kill4n/FEALAC/Hardware/renders/rend.JPG

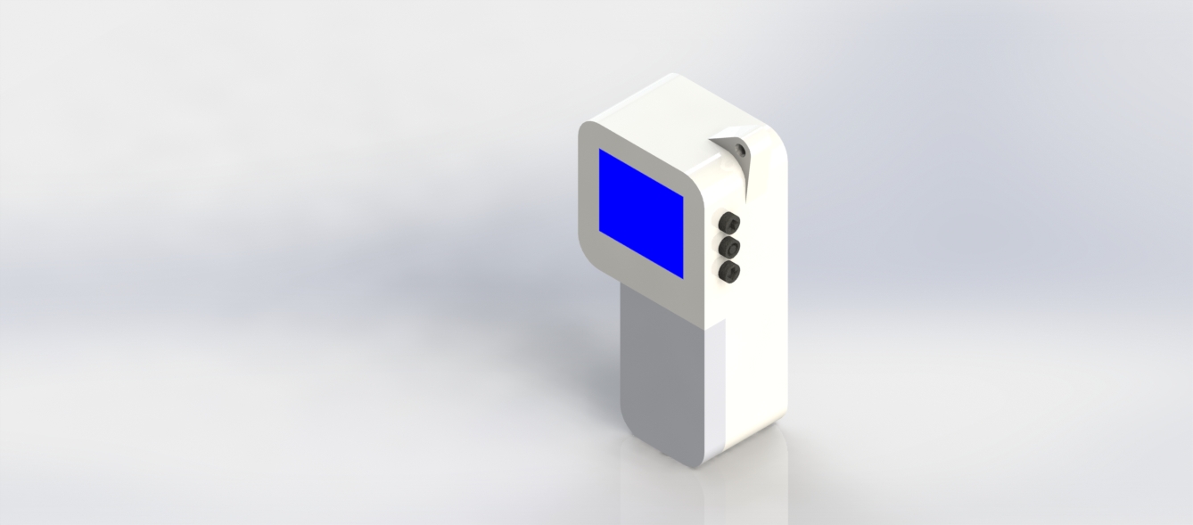
Hardware/renders/rend.JPG
