kill4n/FEALAC/Hardware/renders/rendexp.JPG

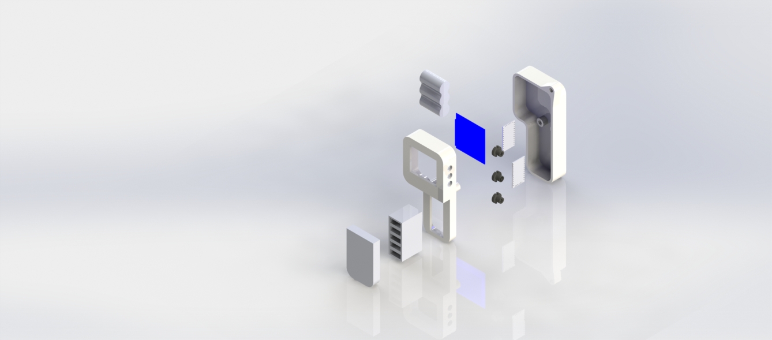
Hardware/renders/rendexp.JPG
