kill4n/FEALAC/Hardware/Ensamblaje1.SLDASM

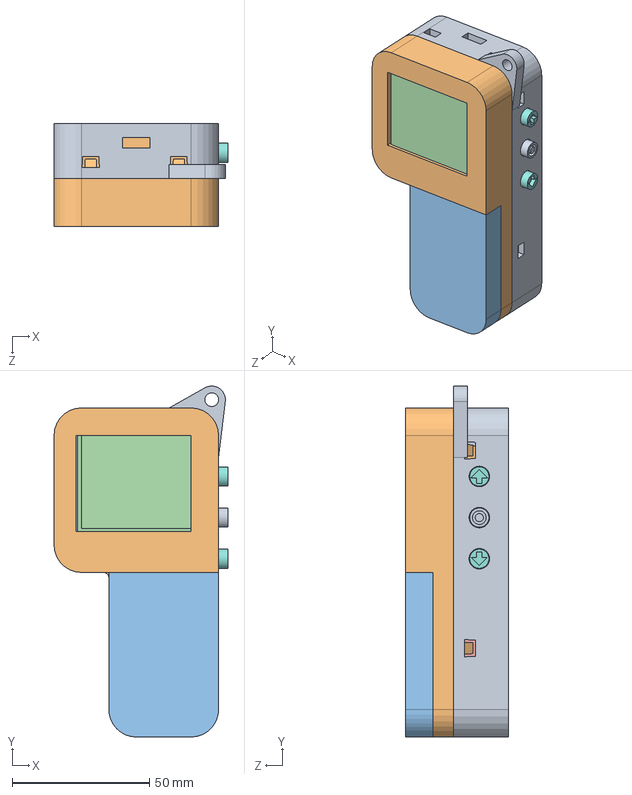
[picture p24: CAD file, 2016-03-14]
Hardware/Ensamblaje1.SLDASM
63.4 x 128.0 x 37.5 mm
Caja_Solido_base
Caja_SolidoA1
Boton_ARROW x 2
Boton_Sel
