kill4n/FEALAC/Hardware/sensor.SLDPRT

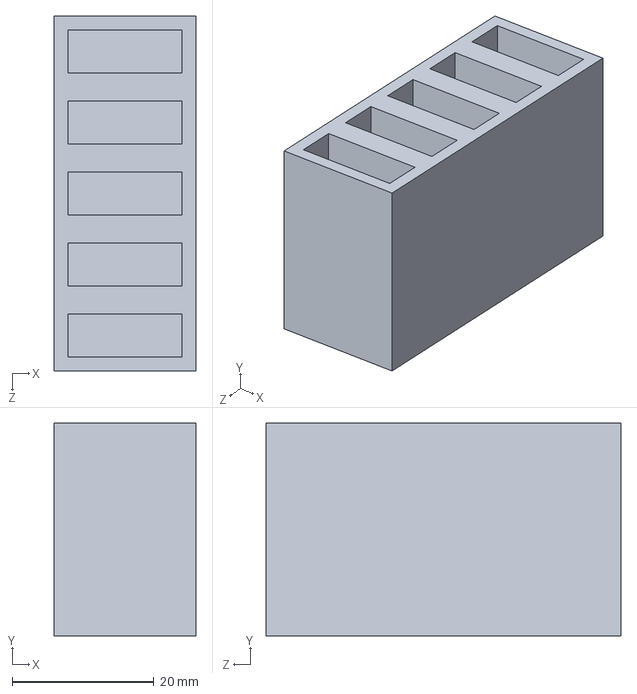
[picture p25: CAD file, 2016-03-14]
Hardware/sensor.SLDPRT
20.0 x 30.0 x 50.0 mm
