kill4n/FEALAC/Hardware/Boton_DOWN.SLDPRT

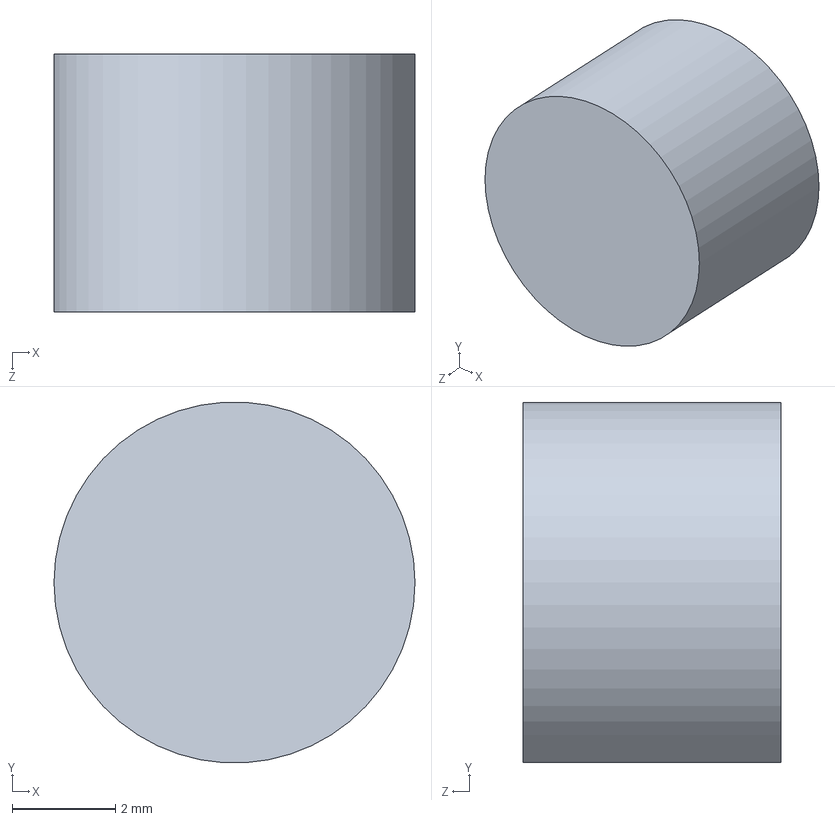
[picture p26: CAD file, 2016-03-14]
Hardware/Boton_DOWN.SLDPRT
7.00 x 6.99 x 5.00 mm
