kill4n/FEALAC/Hardware/Caja_Solido_base.SLDPRT

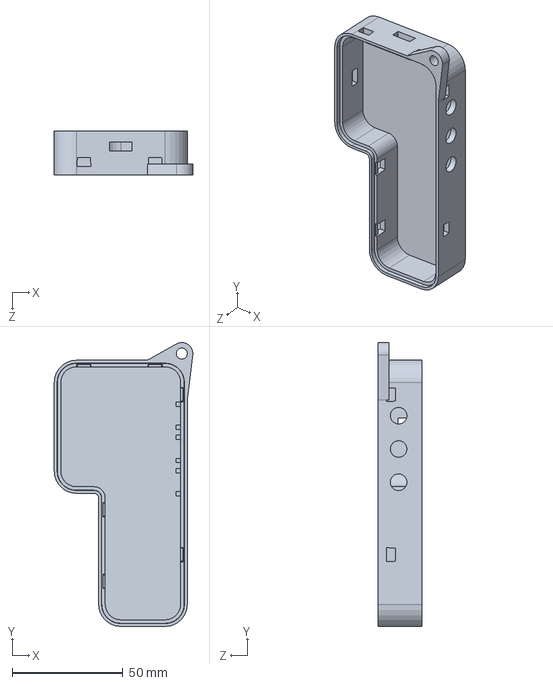
[picture p27: CAD file, 2016-03-14]
Hardware/Caja_Solido_base.SLDPRT
62.5 x 128.0 x 20.0 mm
