kill4n/FEALAC/Hardware/babat.SLDPRT

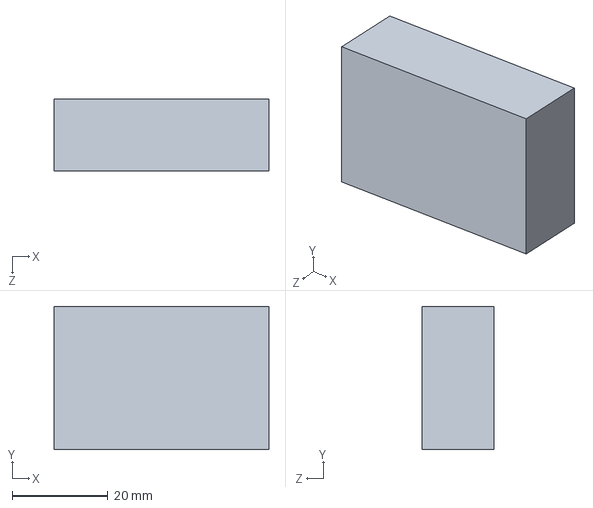
[picture p28: CAD file, 2016-03-14]
Hardware/babat.SLDPRT
45.0 x 30.0 x 15.0 mm
