kill4n/FEALAC/Hardware/BT.SLDPRT

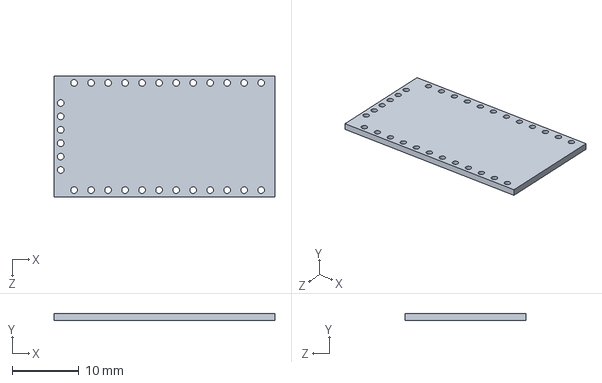
[picture p29: CAD file, 2016-03-14]
Hardware/BT.SLDPRT
33.0 x 1.00 x 18.0 mm
