kill4n/FEALAC/Hardware/Boton_ARROW.SLDPRT

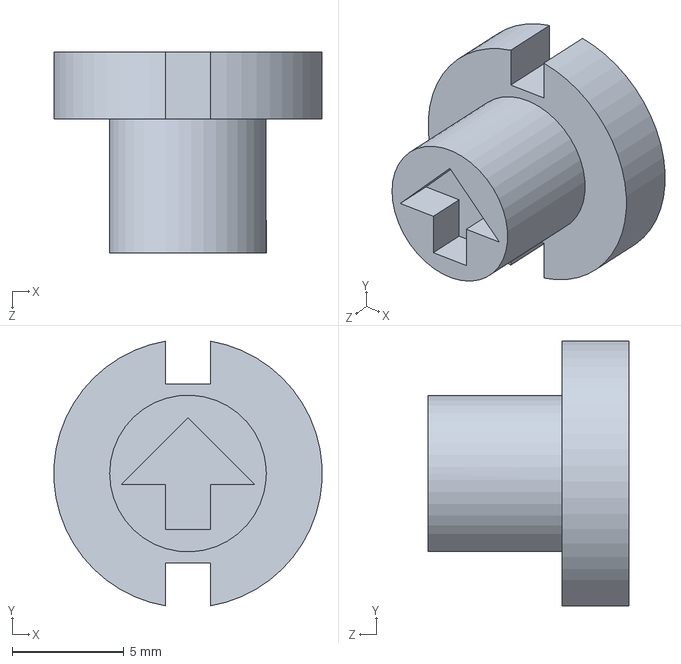
[picture p30: CAD file, 2016-03-14]
Hardware/Boton_ARROW.SLDPRT
12.0 x 11.8 x 9.00 mm
