kill4n/FEALAC/Hardware/Caja_Solido.SLDPRT

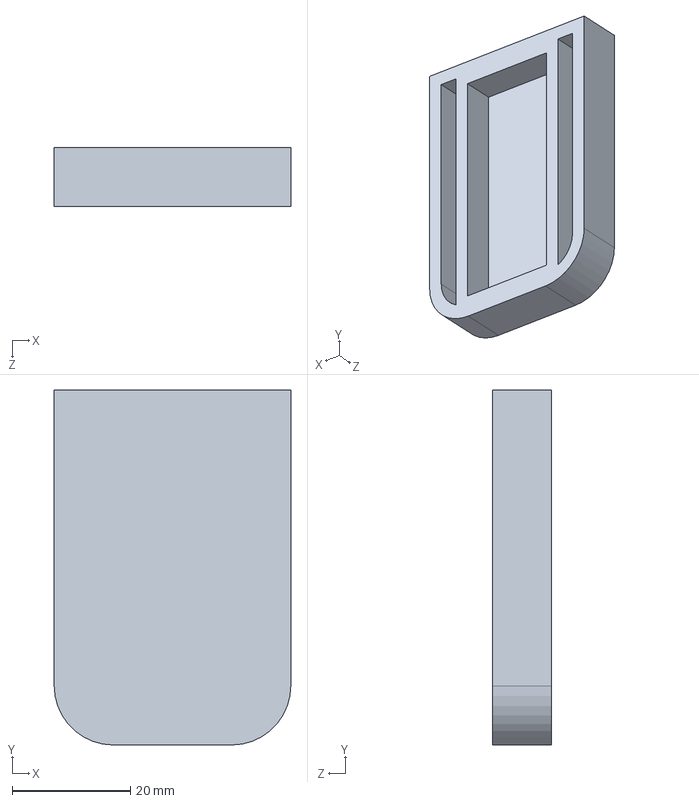
[picture p32: CAD file, 2016-03-14]
Hardware/Caja_Solido.SLDPRT
40.0 x 60.0 x 10.0 mm
