kill4n/FEALAC/Hardware/bateria.SLDPRT

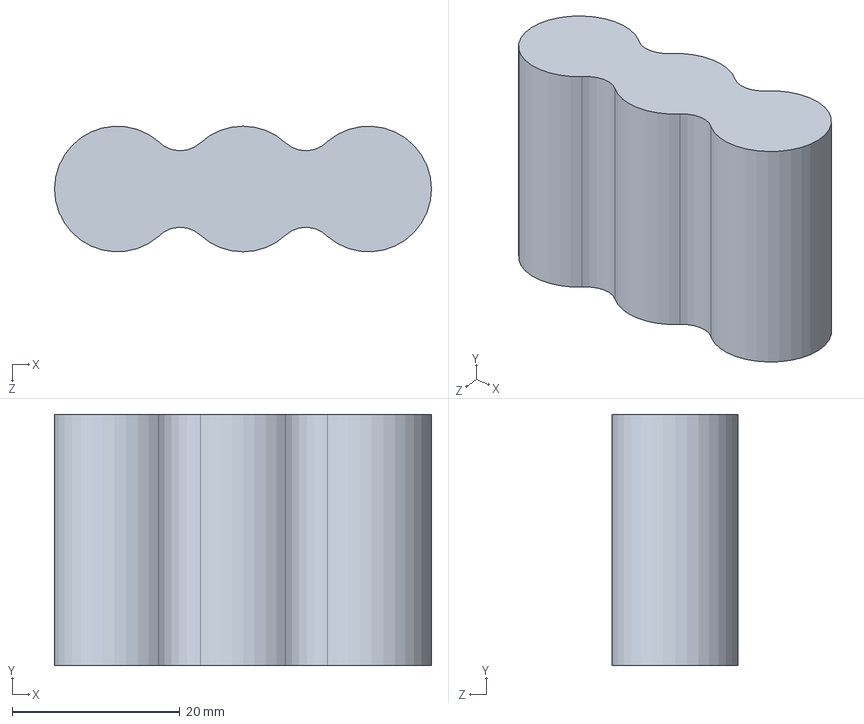
[picture p33: CAD file, 2016-03-14]
Hardware/bateria.SLDPRT
45.0 x 30.0 x 15.0 mm
