kill4n/FEALAC/Hardware/Pantalla.SLDPRT

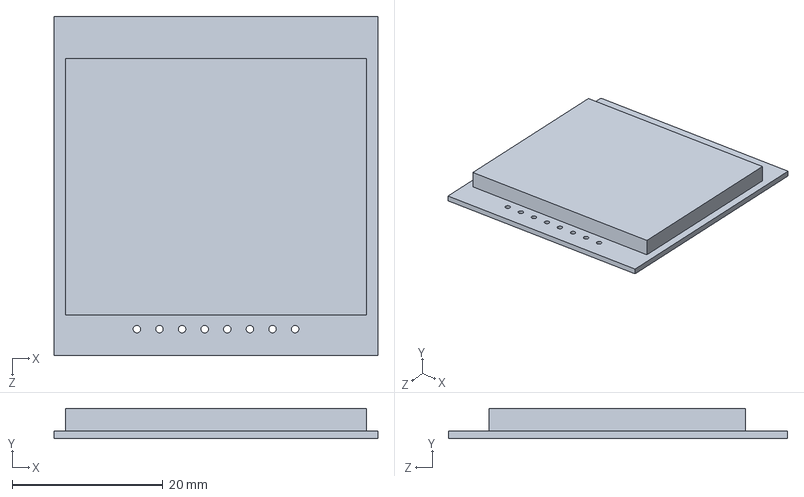
[picture p34: CAD file, 2016-03-14]
Hardware/Pantalla.SLDPRT
43.0 x 4.00 x 45.0 mm
