kill4n/FEALAC/Hardware/Caja_SolidoA1.SLDPRT

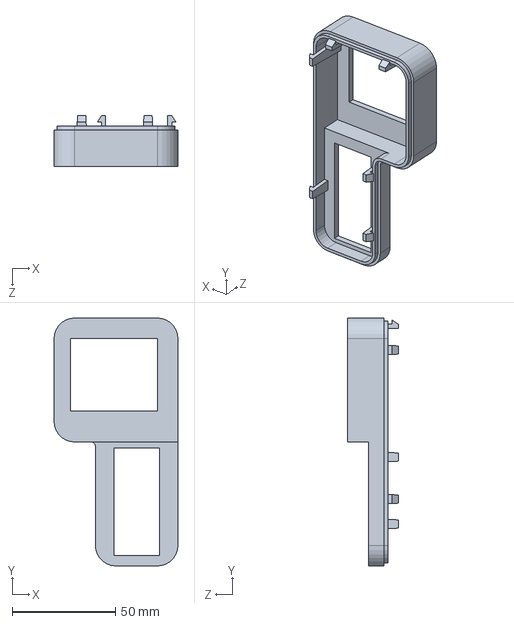
[picture p35: CAD file, 2016-03-14]
Hardware/Caja_SolidoA1.SLDPRT
60.0 x 120.0 x 24.5 mm
