kill4n/FEALAC/Hardware/Caja_SolidoA.SLDPRT

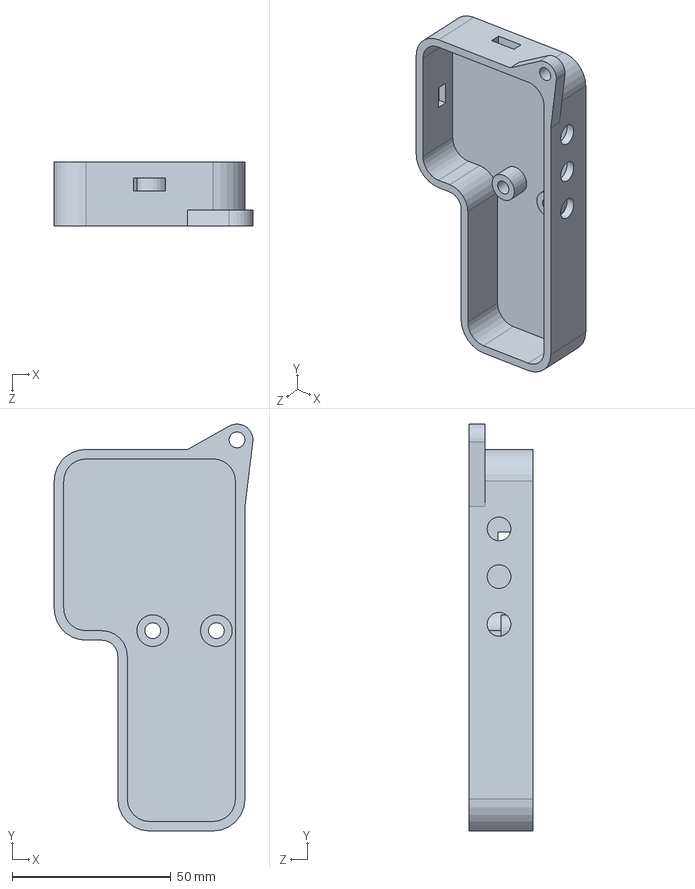
[picture p36: CAD file, 2016-03-14]
Hardware/Caja_SolidoA.SLDPRT
62.5 x 128.0 x 20.0 mm
