kill4n/FEALAC/(list of files, cad)

Other CAD files:
Hardware/plano_1.SLDDRW
