kill4n/FEALAC/Hardware/plano_1.PDF

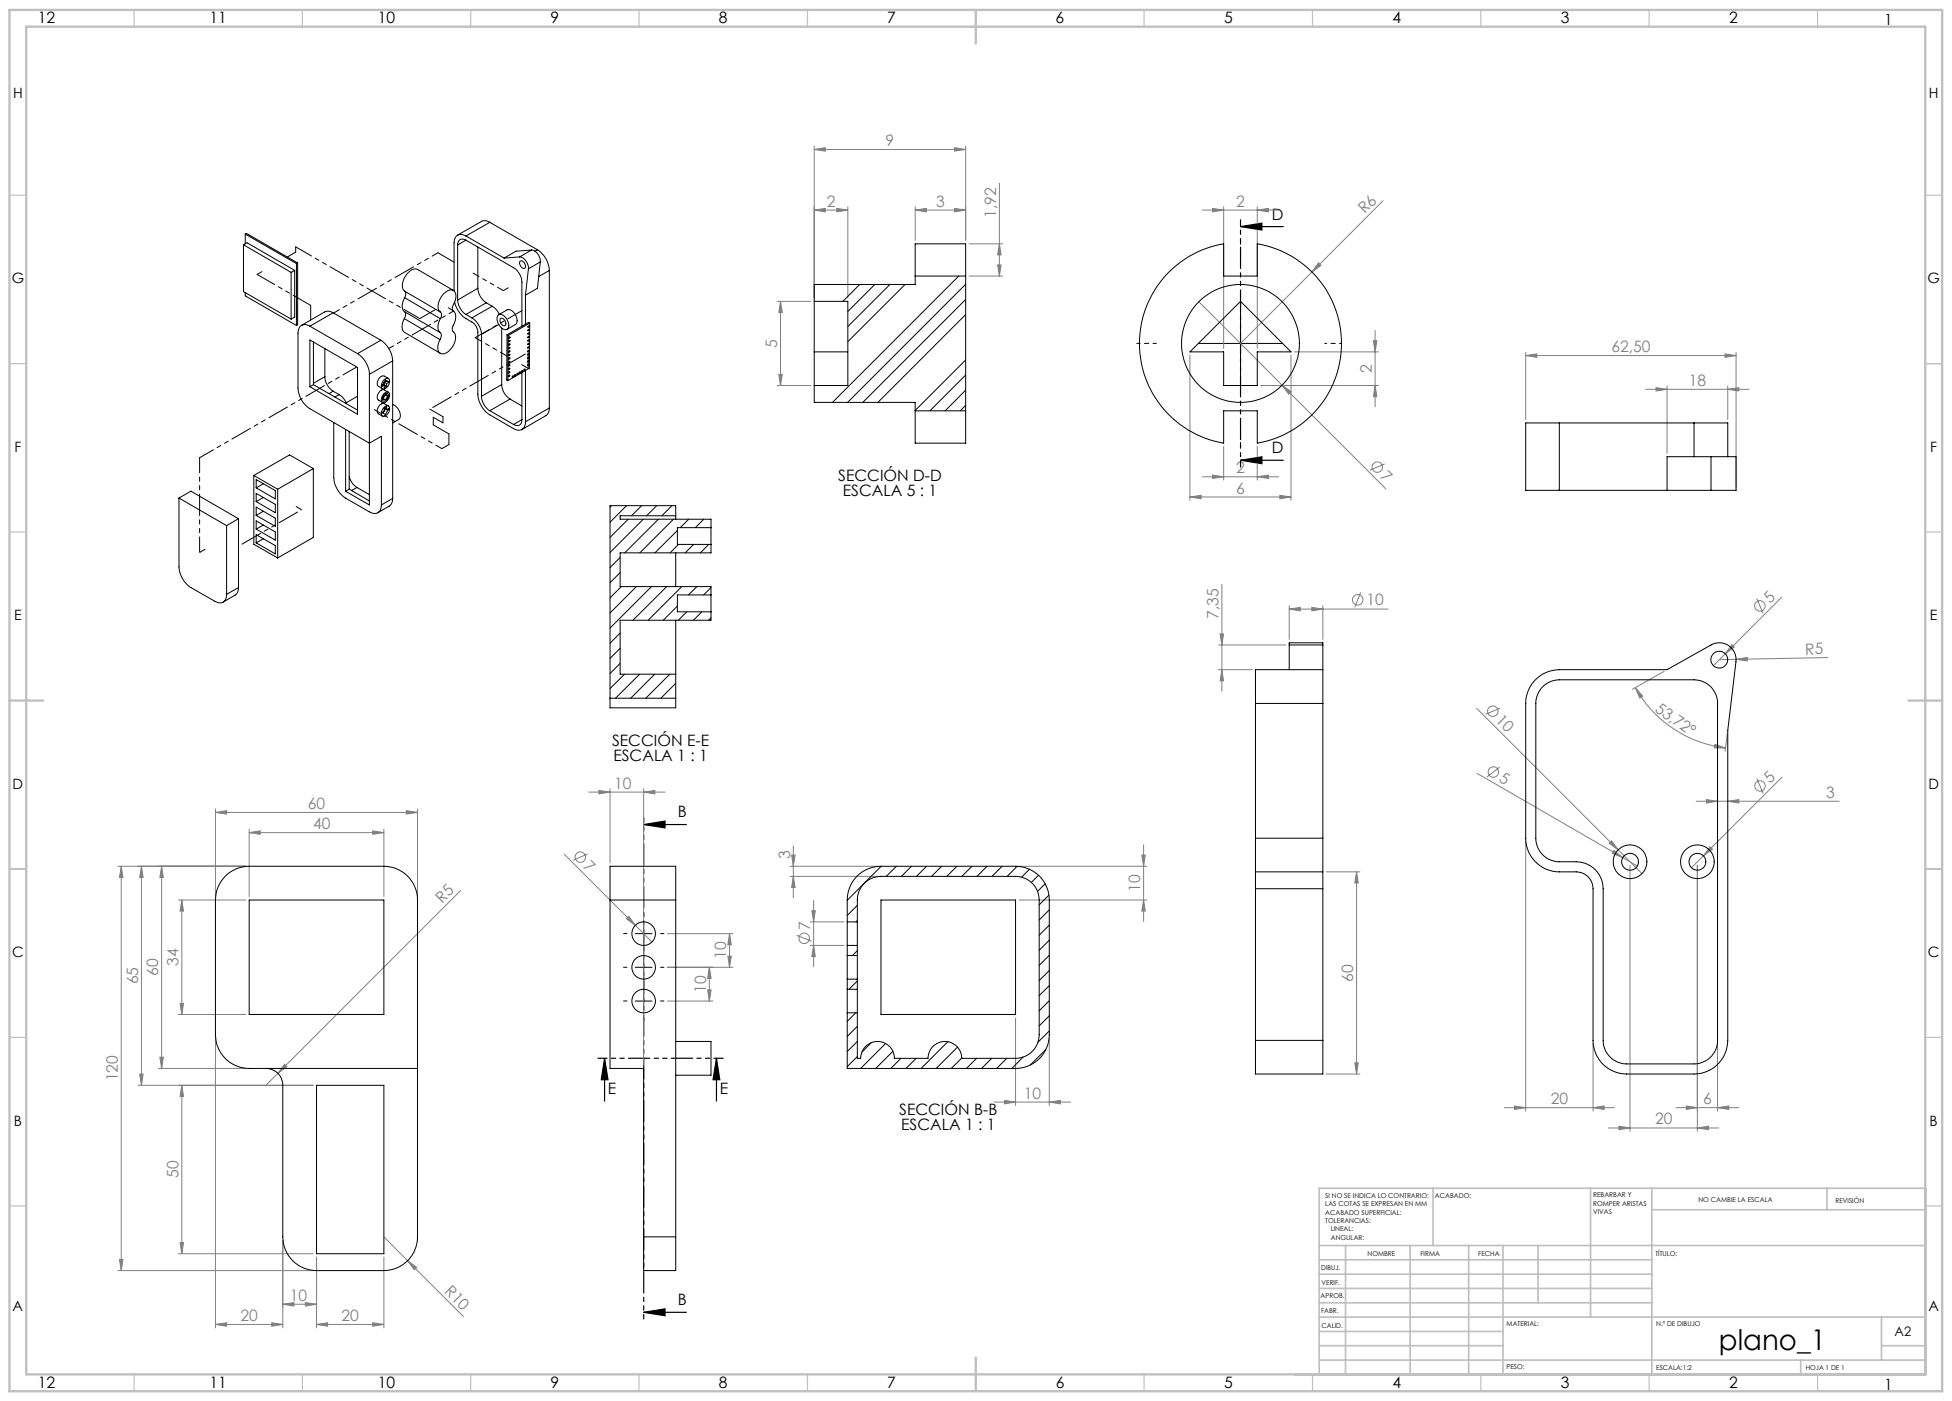
[picture p38: page 1]
SECCIÓN B-B ESCALA 1 : 1; SECCIÓN D-D ESCALA 5 : 1; SECCIÓN E-E ESCALA 1 : 1; ACABADO:; REBARBAR Y; ROMPER ARISTAS; NO CAMBIE LA ESCALA; REVISIÓN; ESCALA:1:2; HOJA 1 DE 1

SI NO SE INDICA LO CONTRARIO:
LAS COTAS SE EXPRESAN EN MM
ACABADO SUPERFICIAL:
TOLERANCIAS:
LINEAL:
ANGULAR:

NOMBRE | FIRMA | FECHA | | | | TÍTULO:

DIBUJ.
VERIF.
APROB.
FABR.
CALID. | | | | MATERIAL: | N.º DE DIBUJO plano_1 | A2
