kill4n/FEALAC/Electronic/FEALAC/fealac_circuito.pdf

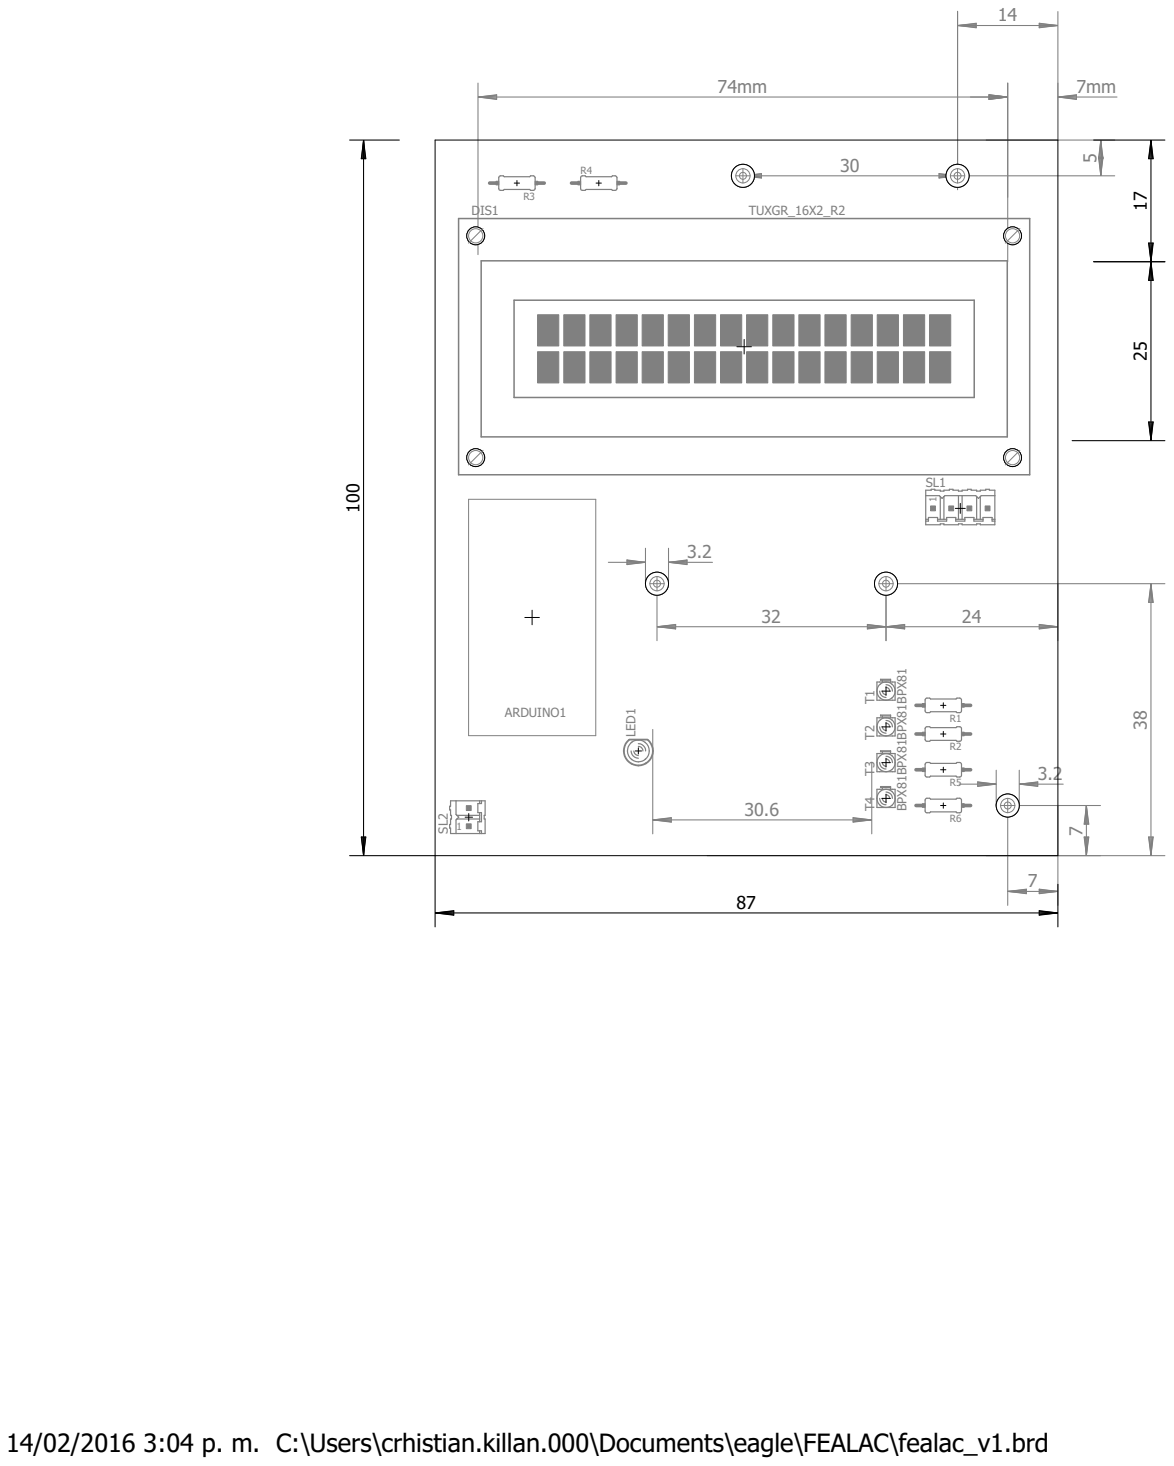
[picture p39: page 1]

14/02/2016 3:04 p. m. C:\Users\crhistian.killan.000\Documents\eagle\FEALAC\fealac_v1.brd
