kill4n/FEALAC/Electronic/FEALAC/fealac_v1.brd

## EAGLE design Electronic/FEALAC/fealac_v1.brd (2016-03-14)

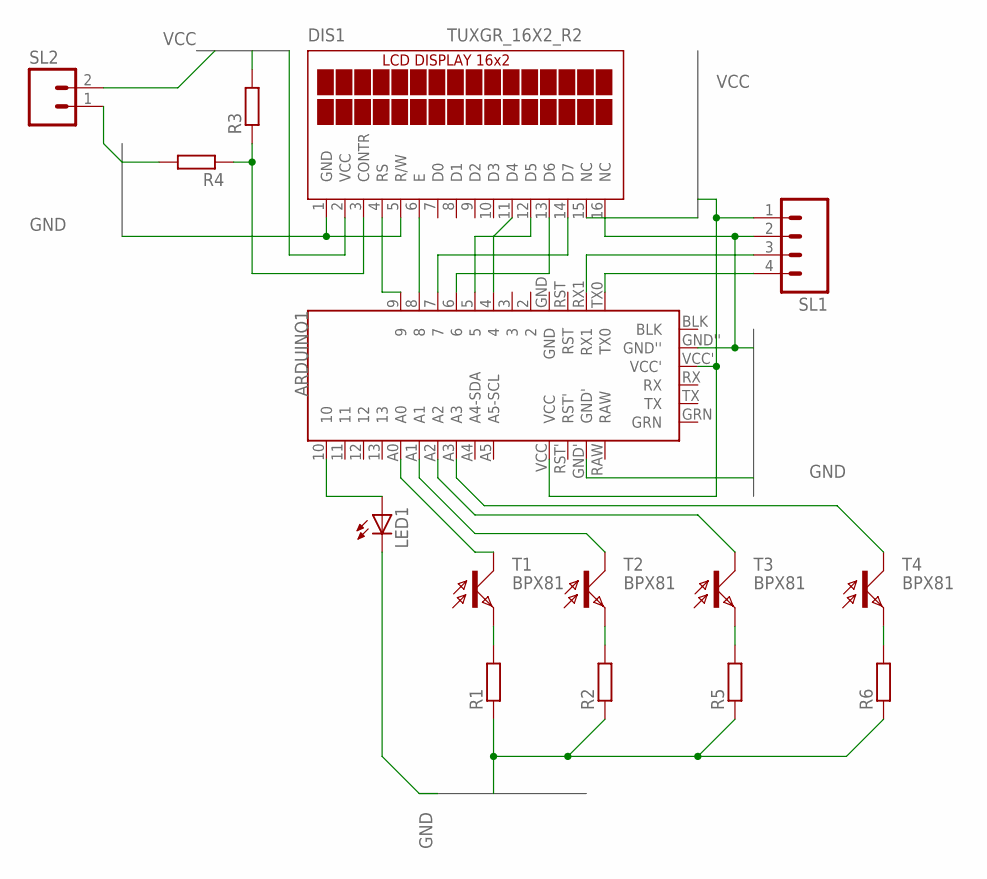
[picture p40: schematic fealac_v1.sch]

Parts:
ARDUINO1: ARDUINO_PRO_MINI_V2
DIS1: TUXGR_16X2_R2
LED1: LED3MM
R1, R2, R3, R4, R5, R6: R-EU_0204/7; 0204/7
SL1: M04; 04P
SL2: M02; 02P
T1, T2, T3, T4: BPX81

Connections:
GND: ARDUINO1.GND', ARDUINO1.GND'', DIS1.1 (GND), DIS1.5 (R/W), DIS1.16 (NC), LED1.K (C), R1.1, R2.1, R4.2, R5.1, R6.1, SL1.2, SL2.1
unnamed: DIS1.3 (CONTR), R3.1, R4.1
unnamed: ARDUINO1.4, DIS1.11 (D4)
unnamed: R1.2, T1.E
unnamed: ARDUINO1.RX1, SL1.3
unnamed: ARDUINO1.TX0, SL1.4
unnamed: ARDUINO1.10, LED1.A
unnamed: R6.2, T4.E
unnamed: ARDUINO1.9, DIS1.4 (RS)
unnamed: ARDUINO1.8, DIS1.6 (E)
unnamed: ARDUINO1.7, DIS1.14 (D7)
unnamed: ARDUINO1.6, DIS1.13 (D6)
unnamed: ARDUINO1.5, DIS1.12 (D5)
unnamed: R2.2, T2.E
unnamed: R5.2, T3.E
unnamed: ARDUINO1.A0, T1.C
unnamed: ARDUINO1.A1, T2.C
unnamed: ARDUINO1.A2, T3.C
unnamed: ARDUINO1.A3, T4.C
VCC: ARDUINO1.VCC, ARDUINO1.VCC', DIS1.2 (VCC), DIS1.15 (NC), R3.2, SL1.1, SL2.2

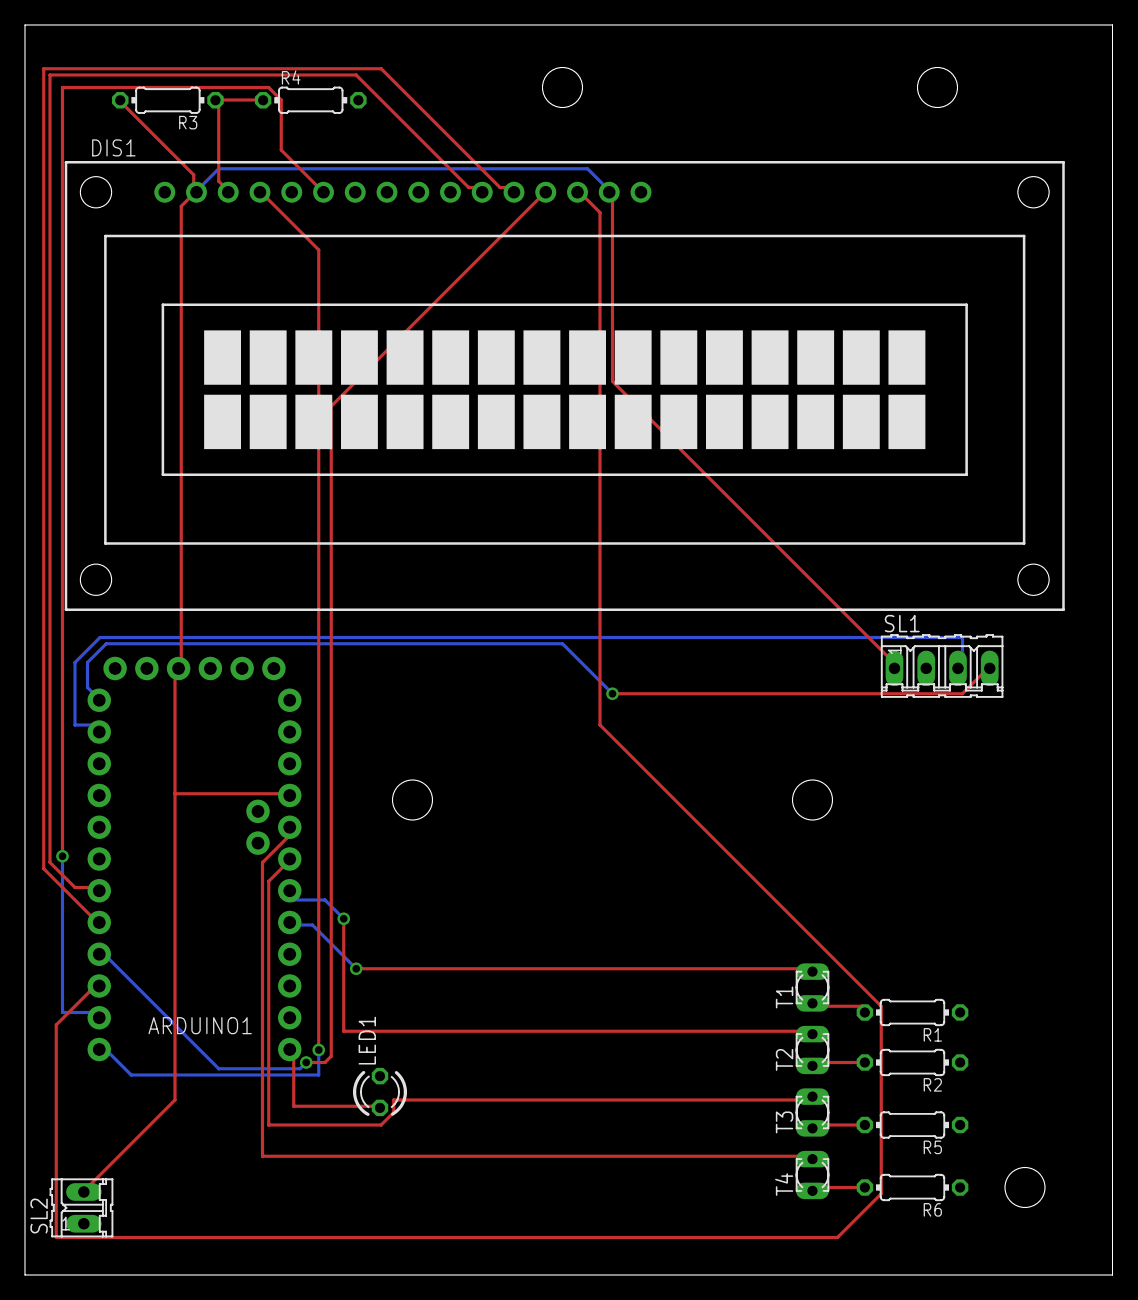
[picture p41: board fealac_v1.brd from above]

Board: 2 copper layers, 87.0 x 100.0 mm, 15 parts (0 on the bottom side), 20 nets.
